DK6v/board-flow-meter/README.md

## Description
Board to measure and report on metrics from the water flow meter.
