DK6v/board-flow-meter/kicad/flow-meter/flow-meter.kicad_sch

## KiCad design kicad/flow-meter/flow-meter.kicad_sch (2025-06-05)

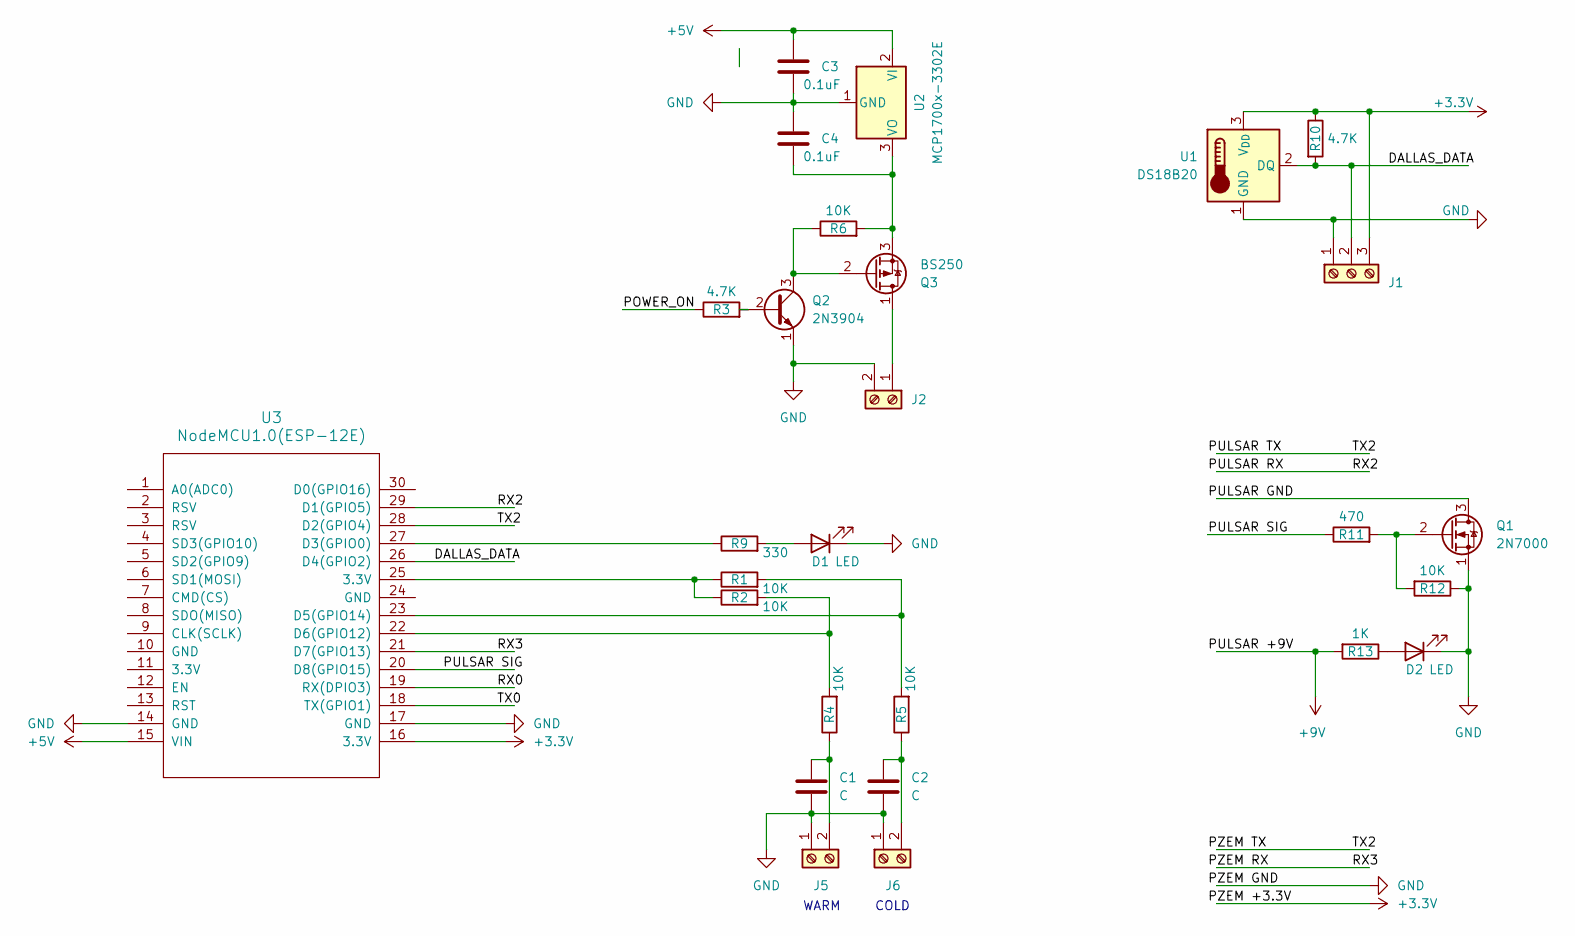
[picture p1: schematic flow-meter.kicad_sch]

Parts:
C1, C2: C
C3, C4: 0.1uF
D1, D2: LED
J1: Screw_Terminal_01x03
J2: Screw_Terminal_01x02
J5, J6: (no value)
Q1: 2N7000; TO-92_Inline
Q2: 2N3904; TO-92_Inline
Q3: BS250; TO-92_Inline
R1, R2, R4, R5, R6, R12: 10K
R3, R10: 4.7K
R9: 330
R11: 470
R13: 1K
U1: DS18B20; TO-92_Inline
U2: MCP1700x-3302E; TO-92_Inline
U3: NodeMCU1.0(ESP-12E)

Connections:
+3.3V: J1.3, R10.1, U1.3 (V_{DD}), U3.16 (3.3V)
+5V: C3.1, U2.2 (VI), U3.15 (VIN)
+9V: R13.2
DALLAS_DATA: J1.2, R10.2, U1.2 (DQ), U3.26 (D4(GPIO2))
GND: C1.2, C2.2, C3.2, C4.1, D1.1 (K), D2.1 (K), J1.1, J2.2, J5.1, J6.1, Q1.1 (S), Q2.1 (E), R12.1, U1.1 (GND), U2.1 (GND), U3.14 (GND), U3.17 (GND)
unnamed: C1.1, J5.2, R4.1
unnamed: C2.1, J6.2, R5.1
unnamed: C4.2, Q3.3 (S), R6.2, U2.3 (VO)
unnamed: D1.2 (A), R9.2
unnamed: D2.2 (A), R13.1
unnamed: J2.1, Q3.1 (D)
unnamed: Q1.2 (G), R11.2, R12.2
unnamed: Q2.2 (B), R3.2
unnamed: Q2.3 (C), Q3.2 (G), R6.1
unnamed: R1.1, R2.1, U3.25 (3.3V)
unnamed: R1.2, R5.2, U3.23 (D5(GPIO14))
unnamed: R2.2, R4.2, U3.22 (D6(GPIO12))
unnamed: R9.1, U3.27 (D3(GPIO0))
POWER_ON: R3.1
PULSAR SIG: R11.1, U3.20 (D8(GPIO15))
RX0: U3.19 (RX(DPIO3))
RX2: U3.29 (D1(GPIO5))
RX3: U3.21 (D7(GPIO13))
TX0: U3.18 (TX(GPIO1))
TX2: U3.28 (D2(GPIO4))

Notes on the sheet:
WARM
COLD
