DK6v/board-flow-meter/kicad/flow-meter/untitled.kicad_sch

## KiCad design kicad/flow-meter/untitled.kicad_sch (2025-06-05)

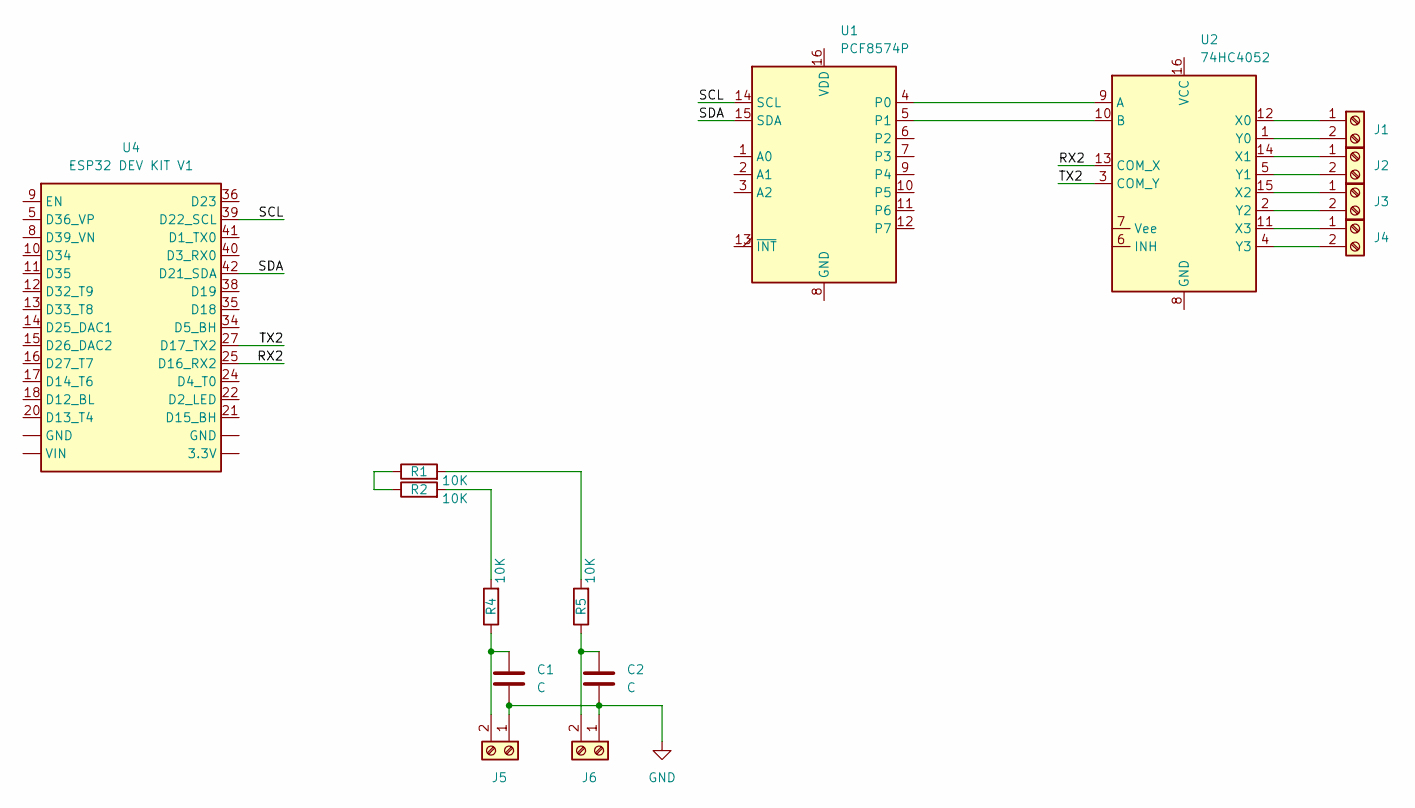
[picture p2: schematic untitled.kicad_sch]

Parts:
C1, C2: C
J1, J2, J3, J4, J5, J6: (no value)
R1, R2, R4, R5: 10K
U1: PCF8574P
U2: 74HC4052
U4: ESP32 DEV KIT V1

Connections:
GND: C1.2, C2.2, J5.1, J6.1
unnamed: C1.1, J5.2, R4.1
unnamed: C2.1, J6.2, R5.1
unnamed: J1.1, U2.12 (X0)
unnamed: J1.2, U2.1 (Y0)
unnamed: J2.1, U2.14 (X1)
unnamed: J2.2, U2.5 (Y1)
unnamed: J3.1, U2.15 (X2)
unnamed: J3.2, U2.2 (Y2)
unnamed: J4.1, U2.11 (X3)
unnamed: J4.2, U2.4 (Y3)
unnamed: R1.1, R2.1
unnamed: R1.2, R5.2
unnamed: R2.2, R4.2
unnamed: U1.4 (P0), U2.9 (A)
unnamed: U1.5 (P1), U2.10 (B)
RX2: U2.13 (COM_X), U4.25 (D16_RX2)
SCL: U1.14 (SCL), U4.39 (D22_SCL)
SDA: U1.15 (SDA), U4.42 (D21_SDA)
TX2: U2.3 (COM_Y), U4.27 (D17_TX2)
