DK6v/board-flow-meter/(commit log)

2026-06-20 feat: fetch wall-clock time from CoAP config server and show it in the web UI
    Port the CoAP/CBOR client from board-water-filter into board-flow-meter and
    add a Clock that anchors the server-provided UNIX epoch to millis(). Since the
    flow-meter runs continuously, syncClock() refreshes the anchor hourly to correct
    drift and survive the ~49.7 day millis() rollover.
    Expose the current time as a read-only line at the bottom of the WiFiManager
    param page via CurrentTimeText, which overrides the virtual getCustomHTML() so
    the UTC time + epoch render fresh on every page load (shows "not synced" until
    the first fetch succeeds).
    [main.cpp]
2026-08-19 fix: sensor lookup bug, type mismatches, wrong log, and namespace comments
    - Fix self-comparison bug in DSSensorPin::get() that always matched first sensor
    - Fix mLastState type from msec to uint8_t in PinCounter
    - Fix mBucket type from uint64_t to uint32_t for consistency
    - Fix CH_TEMPC_DELTA log printing mChTempOut instead of mChTempDelta
    - Remove duplicate default parameter in Coap::request definition
    - Remove redundant mid-file includes in main.cpp
    - Fix namespace closing comments from fm to app across 10 files
    Bump version to 1.0.1.
    [PinCounter.cpp, PinCounter.h, PinLed.cpp, PinLed.h, PinOut.cpp, PinOut.h]
2026-10-22 fix: millis() rollover handling and WiFi setup portal timeout
    - Compare timer deadlines via signed difference in TimerDispatcher so
    timers don't fire on every loop iteration before millis() rollover
    - Fix Pulsar update interval check that returned stale data for ~49 days
    after millis() rollover
    - Fix PinCounter poll interval check that could stall water counters
    after millis() rollover
    - Limit WiFiManager setup portal to 180 s and restart, so the device
    doesn't hang in AP mode when the router boots slower after power loss
    Bump version to 1.0.2.
2026-10-22 feat: store config in a flash journal
    - Switch to config 2.0.0 (pinned by commit): parameters are stored in a
    journal in the FS area instead of EEPROM, only changed parameters are
    appended, so a flash sector isn't erased on every counter update
    - Keep meter totals as uint32_t instead of float, which lost units above
    2^24 (electricity total in Wh)
    - Parse web form totals as double and round them, so saving the form
    doesn't change the counters
    Values stored by the previous version are not migrated: save them from
    /param before flashing and submit the form afterwards.
    Bump version to 1.1.0.
2026-10-22 dev: pin all dependencies to exact versions
    - Pin console, reporter, checksum and macros to v1.0.0 and config to
    v2.0.0, so a clean build uses the same library code as the deployed
    firmware (reporter HEAD already differs from v1.0.0)
    - Pin the espressif8266 platform to 4.2.1
    - Pin third-party libraries with their owners: several packages matched
    OneWire@^2.3.7
    Bump version to 1.1.3.
2026-10-22 fix: power correction, heat total and DS18B20 readings
    - Send the firmware version and the last reset reason to syslog at boot
    - Apply the power correction as Wh per counted kWh instead of per Wh,
    and apply the stored correction at boot
    - Store the heat energy total only after a successful Pulsar reading,
    a failed first reading after boot overwrote it with 0
    - Skip DS18B20 readings of -127 (no answer) and 85 (power-on value)
    Bump version to 1.1.4.
2026-10-22 fix: read Pulsar responses by frame
    - Finish receiving as soon as the response frame is complete instead of
    waiting 3 s for a 64-byte buffer, the response is 38 bytes
    - Skip noise bytes before the meter address
    - Wait up to 1 s per attempt and retry for up to 6 s, the meter may miss
    the first request after power-on
    - Check the response size against the requested channels
    - Log the attempt and the time a successful reading took
    Bump version to 1.1.5.
2026-10-22 fix: shorter Pulsar retry and stored heat total in the boot log
    - Repeat a Pulsar request after 300 ms without an answer instead of 1 s,
    the meter answers in ~65 ms
    - Log the stored heat total at boot instead of 0 before the first reading
    Bump version to 1.1.6.
2026-10-22 fix: update reporter to 1.0.1
    - Clear headers on every report: since 1.1.3 the device_id tag piled up,
    broke the metrics and leaked memory
    - Send fractional values with 6 decimals instead of 6 significant digits
    - Don't crash on a "%" in the measurement name
    Bump version to 1.1.7.
2026-10-22 feat: send each poll's metrics in one connection
    - Update reporter to 1.1.0 and wrap every timer callback in
    beginBatch()/commit(), so a poll uses one connection instead of one
    per metric
    - Limit resolving the host and connecting to 2 s, an unreachable server
    delays a poll once instead of for every metric
    Bump version to 1.1.9.
2026-10-25 fix: update macros to 1.0.1
    - ROUNDF converts through int64_t: the Pulsar volume above 2147.48 m3
    was clamped, the electricity total would have been at 21474.8 kWh
    - ROUNDF rounds negative values to the closest value, e.g. the Pulsar
    temperature delta
    Bump version to 1.1.10.
2026-10-25 feat: web portal instead of WiFiManager
    - Replace tzapu/WiFiManager with piolibs/portal 1.0.0: pages are streamed
    in small chunks instead of being built in one String, changes are POSTs
    with a per-boot token, so other sites opened in a LAN browser can't
    overwrite the meter totals
    - Meter totals and settings are bound to their config IDs and read from
    config on every request, drop the parameter copies updated from loop()
    and the timers; edited values are applied to the sensors by onChange
    - Dashboard on port 80 with the totals and device time, settings on /edit,
    /request on the local port only
    - Read-only public port 8080: dashboard and /api/values with the meter
    totals, to publ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
2026-10-25 feat: request button on the dashboard
    - Update portal to 1.1.0: dashboard actions and the firmware version on
    the local dashboard
    - "Request measurements" button on the local dashboard: shows
    "Requesting…" while the meters are read, then "Measurements sent" with
    the time; GET /request for scripts stays, neither is on the public port
    - Firmware +2.4 KB, static RAM +88 bytes
    Bump version to 2.1.0.
2026-11-07 fix: CoAP and CBOR parsing, Pulsar energy check
    - CoAP request copied 12 bytes from a 7-byte literal; now copies the
    literal only and refuses resources longer than the option allows
    - CoAP response is accepted only with the request's message ID and an
    empty token, from the server's address; options with extended lengths
    are skipped and timestamps before 2024 are ignored
    - CBOR maps with 16–23 entries were parsed with a wrong size, negative
    1-byte integers came out positive, parsing is bounded to the packet
    - Pulsar channel values are initialized, the first reading doesn't use
    garbage
    - Heat energy is stored only when it's finite, non-negative and fits
    uint32_t, a bad reading is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
2026-11-07 feat: CoAP client from piolibs/coap
    - Use the piolibs/coap 1.0.0 library for the clock sync request;
    app::Coap and app::Cbor are replaced by coap::Client, the UDP socket
    is app::WifiTransport implementing coap::Transport
    - The CoAP message ID is random for each sync
    - Firmware is ~1.5 KB smaller in flash and ~0.7 KB smaller in RAM
    Incompatible for code that used app::Coap: sync takes a message ID and
    returns bool.
    Bump version to 2.2.0.
